EugeneCarlo/ESPidi/Schematic/Scheme ESPidi.jpg

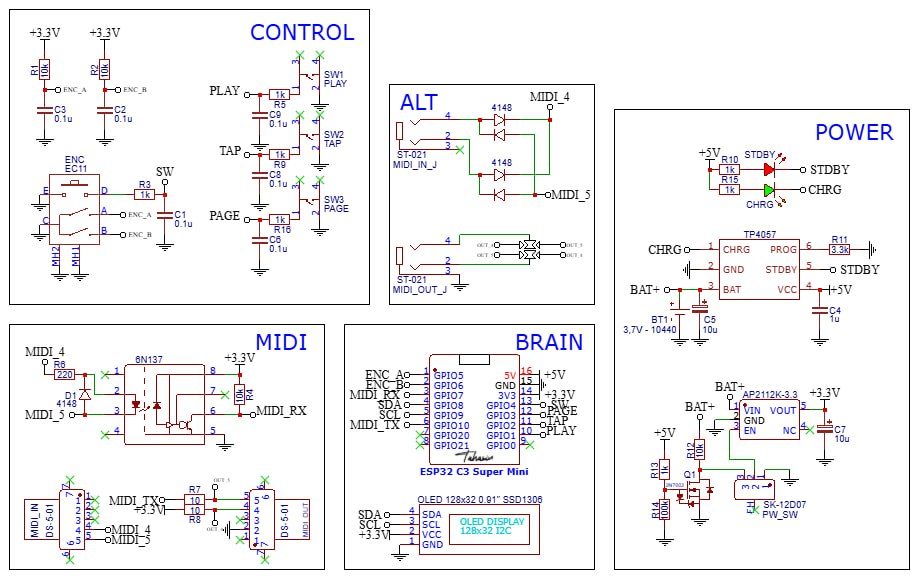
Schematic/Scheme ESPidi.jpg
