EugeneCarlo/ESPidi/BOM/BOM.md

### [Download xlsx](https://github.com/EugeneCarlo/ESPidi/blob/main/BOM/BOM_ESPidi.xlsx)

## Резисторы

| Номинал | Описание | Количество |
| --- | --- | --- |
| 10 | R1206 | 2 шт |
| 220 | R1206 | 1 шт |
| 1k | R1206 | 7 шт |
| 3.3k | R1206 | 1 шт |
| 10k | R1206 | 4 шт |
| 100k | R1206 | 1 шт |

## Конденсаторы

| Номинал | Описание | Количество |
| --- | --- | --- |
| 0.1 | C1206 | 6 шт |
| 1u | C1206 | 1 шт |
| 10u | D5.0×F2.0 | 1 шт |

## Диоды/Транзисторы/Микро

| Номинал | Описание | Количество |
| --- | --- | --- |
| 1N4148 | SOD-123 | 5 шт |
| 2N7002 | SOT-23-3 | 1 шт |
| AP2112K-3.3 | SOT-23-5 | 1 шт |
| TP4057 | SOT-23-6 | 1 шт |
| 6N137 | DIP-8 | 1 шт |
| ESP32 C3 | Super Mini | 1 шт |
| SSD1306 | 128x32 (0.91") | 1 шт |

## Гнезда и другое

| Номинал | Описание | Количество |
| --- | --- | --- |
| ENC | EC11 | 1 шт |
| SW | SMD_SH-6X6X4.5H | 3 шт |
| PW SW | SK-12D07 | 1 шт |
| DIN 5 | DS-5-01 | 2 шт |
| Jack 3.5mm | ST-021 | 2 шт |
| Bat | 10440 | 1 шт |
| Knob | Other  | 1 шт |
