EugeneCarlo/ESPidi/Firmware/ESPidi/hardware.h

#ifndef HARDWARE_H
#define HARDWARE_H

#include <Wire.h>
#include <Adafruit_GFX.h>
#include <Adafruit_SSD1306.h>
#include <MIDI.h>
#include "config.h"

extern Adafruit_SSD1306 display;
extern MIDI_NAMESPACE::MidiInterface<MIDI_NAMESPACE::SerialMIDI<HardwareSerial>> MIDI;

void hw_initDisplay();
void hw_initMIDI();
void hw_initPins();

#endif
