EugeneCarlo/ESPidi/Firmware/ESPidi/seq_mel.h

#ifndef SEQ_MEL_H
#define SEQ_MEL_H

#include <Arduino.h>
#include "config.h"
#include "app.h"
#include "arp.h"

#define MAX_SEQ_STEPS 64
#define MAX_POLY 6
#define MAX_CC_PER_STEP 3
#define STEPS_PER_PAGE 16

struct MelSeqParams {
    uint8_t bpm = 120;
    uint8_t channel = 1;
    uint8_t mode = 0;
    uint8_t length = 16;
    uint8_t gate = 80;
    uint8_t page = 1;
    uint8_t reRec = 1;
    uint8_t strum = 0;
    uint8_t follow = 1;
    uint8_t swing = 0;
    uint8_t randomness = 0;
    uint8_t probability = 0;
};

class MelodicSequencer : public App {
public:
    MelSeqParams params;
    
    void begin() override;
    void update() override;
    void onClockTick() override;
    void resetClockPhase() override;
    
    bool handleNoteOn(uint8_t note, uint8_t velocity) override;
    bool handleNoteOff(uint8_t note) override;
    bool handleCC(uint8_t number, uint8_t value) override;
    bool isEnabled() override { return enabled; }
    
    void play() override;
    void stop() override;
    void toggle() override;
    void tap() override;
    
    void clear();
    void toggleRecord();
    void clearStep(uint8_t step);
    bool saveToFile(uint8_t slot);
    bool loadFromFile(uint8_t slot);
    uint8_t getCurrentPattern() const { return currentPattern; }
    void markDirty() { patternDirty = true; }
    bool isDirty() const { return patternDirty; }
    void markClean() { patternDirty = false; }
    
    uint8_t getCurrentStep() const { return currentStep; }
    void setCurrentStep(uint8_t step) { currentStep = step % MAX_SEQ_STEPS; }
    
    uint8_t getCurrentPage() const { return params.page; }
    bool getHasNote(uint8_t step) const { return noteCount[step] > 0; }
    bool getHasCC(uint8_t step) const { return ccCount[step] > 0; }
    bool getTie(uint8_t step) const { return tie[step]; }
    void setTie(uint8_t step, bool value) { tie[step] = value; }
    void toggleTie(uint8_t step) { tie[step] = !tie[step]; patternDirty = true; }
    uint8_t getNoteCount(uint8_t step) const { return noteCount[step]; }
    uint8_t getCCCount(uint8_t step) const { return ccCount[step]; }
    uint8_t getEditStep() const { return editStep; }
    void setEditStepDirect(uint8_t step) { editStep = step; }
    bool stepEditActive = false;
    bool transposeEditActive = false;
    bool enabled = false;
    uint8_t recording = 0;
    
    int8_t getNoteAt(uint8_t step, uint8_t index) const;
    uint8_t getVelocityAt(uint8_t step, uint8_t index) const;
    uint8_t getCCNumberAt(uint8_t step, uint8_t index) const;
    uint8_t getCCValueAt(uint8_t step, uint8_t index) const;
    int8_t getTranspose(uint8_t step) const;
    void setTranspose(uint8_t step, int8_t value);
    void adjustTranspose(uint8_t step, int8_t delta);
    
    // Чтение данных шага из файла паттерна (без изменения текущего состояния)
    bool getStepData(uint8_t patternSlot, uint8_t step,
        int8_t* outNotes, uint8_t* outVelocities, uint8_t& outNoteCount,
        uint8_t* outCCNum, uint8_t* outCCVal, uint8_t& outCCCount,
        bool& outTie, int8_t& outTranspose, uint8_t& outLength);
    
private:
    int8_t notes[MAX_SEQ_STEPS][MAX_POLY];
    uint8_t velocities[MAX_SEQ_STEPS][MAX_POLY];
    uint8_t noteCount[MAX_SEQ_STEPS];
    bool tie[MAX_SEQ_STEPS];
    int8_t transpose[MAX_SEQ_STEPS];
    
    uint8_t ccNumber[MAX_SEQ_STEPS][MAX_CC_PER_STEP];
    uint8_t ccValue[MAX_SEQ_STEPS][MAX_CC_PER_STEP];
    uint8_t ccCount[MAX_SEQ_STEPS];
    
    uint8_t currentStep = 0;
    uint8_t editStep = 0;
    int8_t direction = 1;
    uint16_t ticksIntoStep = 0;
    
    int lastPlayedNotes[MAX_POLY];
    uint8_t lastPlayedCount = 0;
    
    unsigned long lastTapTime = 0;
    unsigned long lastChordTime = 0;
    bool noteHeld = false;
    uint8_t currentPattern = 0;
    bool patternDirty = false;
    
    void initArrays();
    void stopAllNotes();
    void playStep(uint8_t step, bool doRandomize);
    uint16_t stepTicks() const;
    void doStep();
};

#endif
