EugeneCarlo/ESPidi/(commit log)

2026-08-17 Enhance README.md with detailed project features and hardware specifications; add BOM documentation and initial firmware structure including MIDI handling and arpeggiator implementation.
    [BOM_ESPidi.xlsx]
2026-08-17 Add HARDWARE.md to document hardware pin configuration and update README.md with expanded project features and capabilities
2026-08-17 Update BOM download link to new ESPidi file
2026-08-17 Revise hardware documentation with GPIO details
    Updated GPIO mapping and added sections for OLED, Rotary Encoder, Buttons, MIDI, and Firmware Configuration.
2026-08-17 Fix formatting for GERBER file links in README
